candas-agent/Tringle/images/piece.png

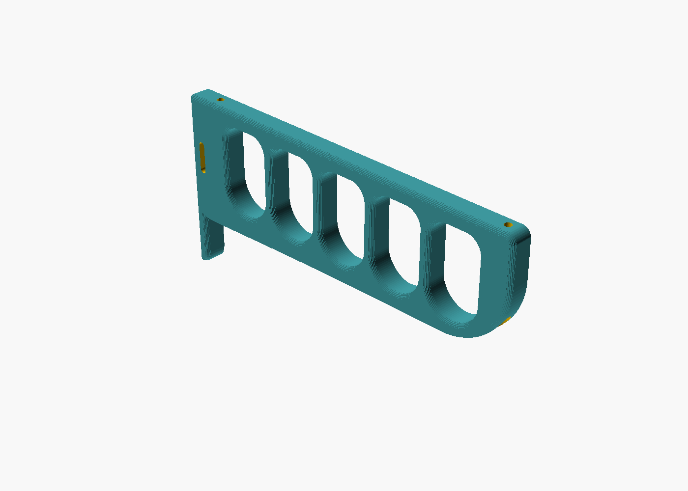
images/piece.png
