candas-agent/Tringle/images/profil.png

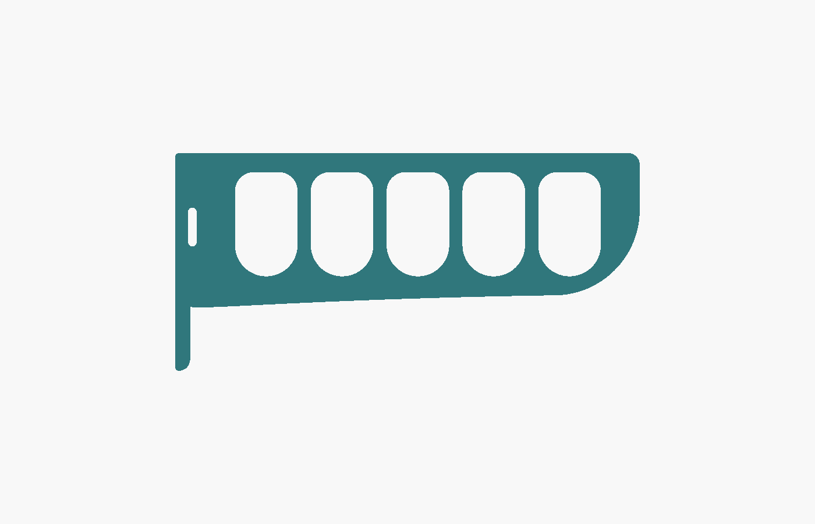
images/profil.png
