candas-agent/Tringle/platine.stl

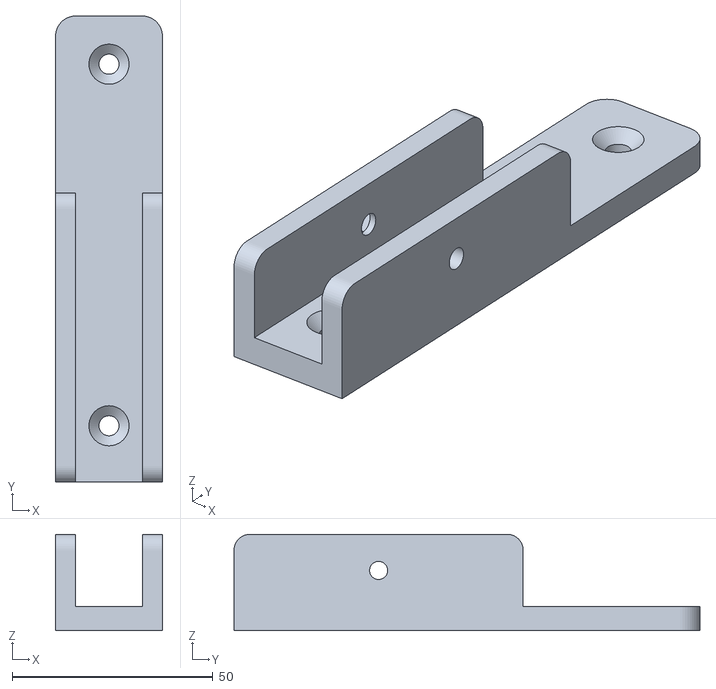
[picture p8: CAD file, 2026-11-13]
platine.stl
26.6 x 116.0 x 24.0
