candas-agent/Tringle/support_cintres.stl

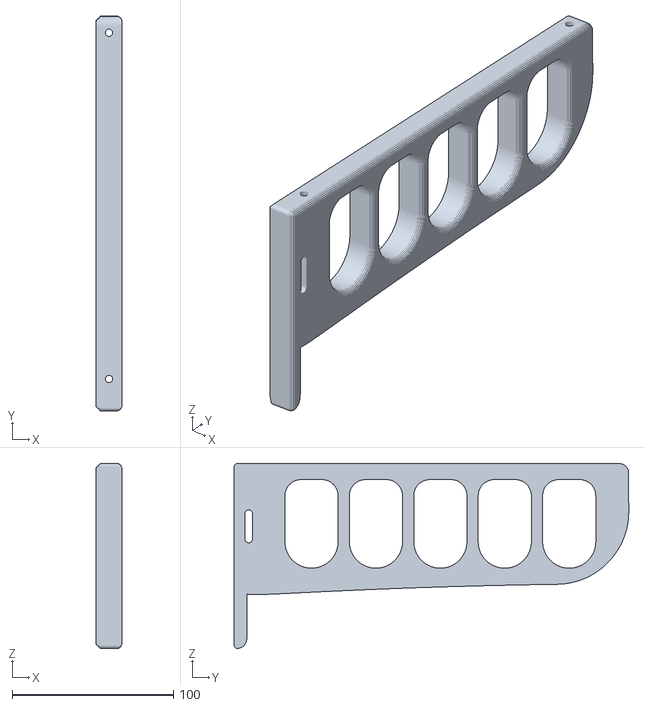
[picture p9: CAD file, 2026-11-13]
support_cintres.stl
16.0 x 245.0 x 114.9
