candas-agent/Tringle/(commit log)

2026-11-10 Ajoute un support de cintres paramétrique OpenSCAD fixé à l'étagère et au fond
    Cadre fermé à 5 encoches, boulonné sous l'étagère (M4 + écrous captifs)
    et vissé au fond. Vérifications d'encombrement vis-à-vis de la porte.
    Claude-Session: https://claude.ai/code/session_011RqstAzemSwR7RYXRYb6vt
    [support_cintres.scad, support_cintres.stl]
2026-11-10 Fixe le support à l'étagère par des vis à bois au lieu de boulons traversants
    Vis posées par en dessous, tête noyée dans un lamage, avec des trous
    d'accès pour le tournevis à travers le bras. Vérifie que les vis ne
    ressortent pas sur le dessus de l'étagère.
    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
    [support_cintres.scad, support_cintres.stl]
2026-11-10 Donne au support une forme plus organique
    Contour en courbes de Bézier (avant en arc, ventre sous le bras, queue
    effilée sous le dos), grands congés dans la fenêtre et arêtes adoucies
    (quart de rond dessus, chanfrein 45° côté plateau). Vis de l'étagère
    déplacées sur les bosses à 28, 108 et 188 mm.
    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
    [support_cintres.scad, support_cintres.stl]
2026-11-10 Relie la barre haute et le bras par des montants en forme d'os
    Un montant sur chaque bosse : le cadre devient une poutre ajourée et
    chaque cintre a son compartiment. Rampe derrière la 1re encoche.
    Vis de l'étagère à 28 et 222 mm, hors des montants (vérifié par assert).
    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
    [support_cintres.scad, support_cintres.stl]
2026-11-10 Supprime les bosses : logements en U et dessous en une seule courbe
    Chaque cintre a un logement aux angles hauts arrondis et au fond en
    demi-cercle, séparé du voisin par un montant. Avant droit qui s'enroule
    dans un grand arrondi, ventre en une seule courbe jusqu'à la queue.
    Vis de l'étagère dans les blocs pleins avant/arrière, posées par des
    tunnels verticaux, positions calculées automatiquement.
    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
    [support_cintres.scad, support_cintres.stl]
2026-11-10 La profondeur de 30 cm est celle de l'étagère, pas de la porte
    Paramètres profondeur_etagere et ecart_porte : la pièce ne doit pas
    dépasser de l'étagère, la dernière veste ne doit pas toucher la porte.
    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
    [support_cintres.scad, support_cintres.stl]
2026-11-13 Affine la pièce pour économiser du filament (~170 g -> ~125 g)
    Largeur 16 mm, barre haute et bras de 10 mm, montants de 7 mm, queue
    plus courte. Les trous d'allègement ont été testés puis écartés : les
    parois ajoutées autour annulent le gain sur le remplissage.
    README : estimation de filament, PLA possible, taille de plateau.
    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
    [support_cintres.scad, support_cintres.stl]
2026-11-13 README : précise le type et la longueur des vis
    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
2026-11-13 Fixation sur les chevilles existantes et une seule vis dans l'étagère
    Nouvelle traverse imprimée à part, vissée dans les deux chevilles du mur
    (côte à côte, entraxe 90 mm). Elle passe dans une fente du support et le
    plaque contre le mur ; un renfort garantit la matière autour de la fente
    à toute hauteur. Seule la vis avant de l'étagère est gardée. Vérifié :
    la traverse ne touche pas le support (chevilles à 35 et 100 mm).
    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
    [support_cintres.scad, support_cintres.stl, traverse.stl]
2026-11-13 Chevilles l'une au-dessus de l'autre : vis du bas de face, rainure en T en haut
    Remplace la traverse (malentendu : les chevilles sont verticales, entraxe
    90 mm). La vis du bas passe sous le bras, accessible de face ; la vis du
    haut, inaccessible au tournevis à cause des montants, s'engage dans une
    rainure en T au dos du support en le glissant de côté.
    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
    [support_cintres.scad, support_cintres.stl, traverse.stl]
2026-11-13 Patte latérale : une vis en haut et une vis en bas, vissées de face
    Remplace la rainure en T. Une plaque verticale contre le mur, sur le côté
    du support, porte les deux trous fraisés des chevilles (entraxe vertical
    90 mm). Les vis sont hors du support : le tournevis ne passe dans aucun
    montant. La patte monte depuis la face du dessus à l'impression, sans
    porte-à-faux. Côté réglable (cote_patte).
    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
    [support_cintres.scad, support_cintres.stl]
2026-11-13 README : estimation de filament avec la patte (~140 g)
    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
2026-11-13 Vis au-dessus et en dessous de la poutre, sur l'axe du support
    La poutre, moins haute (67 mm), tient entre les deux chevilles (entraxe
    vertical 90 mm) avec un dégagement pour le tournevis. La plaque de dos
    porte les deux vis fraisées, vissées de face. Le support ne dépend plus
    de l'étagère : suppression de la vis de l'étagère et de la patte.
    Hauteur libre au-dessus des crochets : 50 mm (vérifiée par assert).
    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
    [support_cintres.scad, support_cintres.stl]
2026-11-13 README : fixation par une vis au-dessus et une vis en dessous de la poutre
    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
2026-11-13 Version en deux pièces : platine sur les chevilles et support réglable en hauteur
    La platine se visse seule dans les deux chevilles (l'une au-dessus de
    l'autre, entraxe 90 mm), avec des creux au dos pour leur collerette. Le
    support se glisse entre ses deux joues, se pousse contre l'étagère, s'y
    visse par en dessous (2 vis) et se bloque par un boulon M4 dans une
    fente verticale (réglage +/- 8 mm) : aucune mesure précise nécessaire.
    Vérifié : les pièces ne se chevauchent pas sur toute la plage de réglage.
    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
    [platine.stl, support_cintres.scad, support_cintres.stl]
